codingABI/id3esp32obd2/(threads)

Thread 1 (2025-07-20):

Elevation calculation wrong?

danjulio, 2025-07-20:
Hello.  This is a nice project.  Thank you for publishing it.

I found it while working on a similar project for an ID.4.  I found the GPS decode especially helpful as the ID.3 spreadsheet that is available online doesn't include it.  However I have a question about the constant value "-501" you subtract from the elevation in meters.  I checked the GPS location in your code as well as a location I got from my house with a couple of online mapping services and it seems that the elevation is more accurate if you subtract 512 ("-512") from the data coming from the car.  Can you tell me how you arrived at the number "-501"?

danjulio, 2025-07-29:
Thank you for replying!

I'm located in Colorado, USA.

I do not have access to another GPS device so I used online topographical maps and entered the same latitude and longitude as I saw in my can bus data.  Subtracting 512 got me an elevation that was close to what the maps reported.  I checked two locations.  It also made more sense to me that they would use a power-of-two number like 512 rather than an odd number like 501 (but, of course, i could be wrong!).

I will try to find a location I can drive to that has a documented elevation and compare the data from the car there.  I understand GPS elevation may be inaccurate by several meters.

codingABI, 2025-07-31:
Colorado, cool :-)

These are some deltas of the last days in my region (Germany/Bavaria):

| OBD2 raw data | Official/real altitude | Delta |
| ------------- | ------------- | ------------- |
| 971 | 467 | 504 |
| 951 | 449 | 502 |
| 1221 | 715 | 506 |
| 1223 | 718 | 505 |
| 979 | 472 | 507 |
| 967 | 460 | 507 |
| 1015 | 513 | 502 |
| 1175 | 673 | 502 |
| 1259 | 757 | 502 |
| 963 | 459 | 504 |

This would be an current average delta of ~504m and I assume that the gps altitude is not more accurate plus/minus 10m.

If you get additional samples from colorado we could complare our deltas.

danjulio, 2025-08-03:
Thanks for the interesting info about GPS.  I don't know that much about it.  Can I ask what resource you use to look up elevations?  And yes, I have an ID.4.

codingABI, 2025-08-03:
In Germany/Bavaria we have several sources to look up elevations.

The easiest way is via the government online map https://atlas.bayern.de. You can right click on any map location and get a popup with the elevation ("Höhe (m)"). I used this method for most of my current samples.

For the other samples I used the other option to download the government elevation data https://geodaten.bayern.de/opengeodata/OpenDataDetail.html?pn=dgm1 as a GeoTiff file. In such a GeoTiff file you can use the gdal tools (more precisely with gdallocationinfo) to read out the elevation for a specific location, e.g.

```
gdallocationinfo.exe 740_5297.tif 12.2055532 47.7830211 -wgs84
Report:
  Location: (108P,838L)
  Band 1:
    Value: 757.720031738281
```

=> Elevation for location 12.2055532 47.7830211 is 758m (Dont be confused about the -wgs84 parameter. This does not mean that the elevation is in wgs84 ellipsoid. Is is only for the used x y coordinate format). GeoTiffs or HGTs with DEM data are also available for Austria, Italiy … and I would guess colorado too.

In general I compare the VW ID.3 GPS data with my Garmin 64st device and from this and other gps devices I know that gps elevation is not very accurate at all.

codingABI, 2025-09-15:
> ...
> * Your altitudes are in the range 1600-1700m and I am in the 450-750m range. I will also try to measure higher altitudes. Maybe there is a correlation.

Small Update:

I got some additional samples with higher altitutes

| OBD2 raw data | Official/real altitude | Delta |
| ------------- | ------------- | ------------- |
| 1291 | 787 |504
| 1497 | 998 | 499
| 1901 | 1400 | 501
| 1915 | 1413 | 502
| 1565 | 1065 | 500

=> The average delta for all my samples is ~503

As a result I
- change the delta from 501 to 503
- added my samples as a comment
- added a link to this conversation

in the source code https://github.com/codingABI/id3esp32obd2/blob/main/id3esp32obd2/requests.ino
