codingABI/id3esp32obd2/id3esp32obd2/dashboards.ino

/* ----------- Dashboards  ----------
 * License: 2-Clause BSD License
 * Copyright (c) 2023-2026 codingABI
 */

// First/starting dashboard
void requestDefaultDashboard(byte boardID) {
  // VIN
  checkBTReceive();
  if (boardID != g_requestDashboard) return; // Bluetooth client changed dashboard
  readAndSendVIN();

  // Driving mode position
  checkBTReceive();
  if (boardID != g_requestDashboard) return; // Bluetooth client changed dashboard
  readAndSendDrivingMode();

  // Car operation mode
  checkBTReceive();
  if (boardID != g_requestDashboard) return; // Bluetooth client changed dashboard
  readAndSendCarMode();

  // ODOMETER
  checkBTReceive();
  if (boardID != g_requestDashboard) return; // Bluetooth client changed dashboard
  readAndSendODOMETER();

  // Outside temperature
  checkBTReceive();
  if (boardID != g_requestDashboard) return; // Bluetooth client changed dashboard
  readAndSendTemperatureOutside();

  // Inside temperature
  checkBTReceive();
  if (boardID != g_requestDashboard) return; // Bluetooth client changed dashboard
  readAndSendTemperatureInside();

  // CO2 content interior
  checkBTReceive();
  if (boardID != g_requestDashboard) return; // Bluetooth client changed dashboard
  readAndSendCO2contentInterior();

  // Voltage for 12V battery from analog pin
  readAndSendBAT12V();

  // Compile time
  readAndSendCompileTime();
}

// Speed dashboard
void requestSpeedDashboard() {
  // Speed
  checkBTReceive();
  readAndSendSpeed();
}

// GPS dashboard
void requestGPSDashboard(byte boardID) {
  checkBTReceive();
  if (boardID != g_requestDashboard) return; // Bluetooth client changed dashboard
  readAndSendGPSTime();

  checkBTReceive();
  if (boardID != g_requestDashboard) return; // Bluetooth client changed dashboard
  readAndSendGPSData();
}

// HV dashboard
void requestHVDashboard(byte boardID) {
  // SOC (BMS)
  checkBTReceive();
  if (boardID != g_requestDashboard) return; // Bluetooth client changed dashboard
  readAndSendSOCBMS();

  // Charging state
  checkBTReceive();
  if (boardID != g_requestDashboard) return; // Bluetooth client changed dashboard
  readAndSendChargingState();

  // CruisingRange
  checkBTReceive();
  if (boardID != g_requestDashboard) return; // Bluetooth client changed dashboard
  readAndSendCruisingRange();

  // Circulation pump HV battery
  checkBTReceive();
  if (boardID != g_requestDashboard) return; // Bluetooth client changed dashboard
  readAndSendHVCirculationPump();

  // HV Battery voltage
  checkBTReceive();
  if (boardID != g_requestDashboard) return; // Bluetooth client changed dashboard
  readAndSendHVBatteryV();

  // HV Battery current
  checkBTReceive();
  if (boardID != g_requestDashboard) return; // Bluetooth client changed dashboard
  readAndSendHVBatteryA();

  // HV Dynamic limit for charging
  checkBTReceive();
  if (boardID != g_requestDashboard) return; // Bluetooth client changed dashboard
  readAndSendHVDynamicChargeLimit();

  // HV Battery main temperature
  checkBTReceive();
  if (boardID != g_requestDashboard) return; // Bluetooth client changed dashboard
  readAndSendHVMainTemperature();

  // HV total charge/discharge
  checkBTReceive();
  if (boardID != g_requestDashboard) return; // Bluetooth client changed dashboard
  readAndSendHVTotalChargeDischarge();

  // HV auxilary consumer power
  checkBTReceive();
  if (boardID != g_requestDashboard) return; // Bluetooth client changed dashboard
  readAndSendHVAuxilaryPower();

  // PTC heater battery
  checkBTReceive();
  if (boardID != g_requestDashboard) return; // Bluetooth client changed dashboard
  readAndSendPTCHeaterCurrent();

   // HV capacity
  checkBTReceive();
  if (boardID != g_requestDashboard) return; // Bluetooth client changed dashboard
  readAndSendHVCapacity();
}

// Custom dashboard
void requestMyDashboard(byte boardID) {
  // SOC (BMS)
  checkBTReceive();
  if (boardID != g_requestDashboard) return; // Bluetooth client changed dashboard
  readAndSendSOCBMS();

  // Car operation mode
  checkBTReceive();
  if (boardID != g_requestDashboard) return; // Bluetooth client changed dashboard
  readAndSendCarMode();

  // HV battery voltage
  checkBTReceive();
  if (boardID != g_requestDashboard) return; // Bluetooth client changed dashboard
  readAndSendHVBatteryV();

  // HV battery current
  checkBTReceive();
  if (boardID != g_requestDashboard) return; // Bluetooth client changed dashboard
  readAndSendHVBatteryA();

  // ODOMETER
  checkBTReceive();
  if (boardID != g_requestDashboard) return; // Bluetooth client changed dashboard
  readAndSendODOMETER();

  // HV total charge/discharge
  checkBTReceive();
  if (boardID != g_requestDashboard) return; // Bluetooth client changed dashboard
  readAndSendHVTotalChargeDischarge();
}
