codingABI/id3esp32obd2/id3esp32obd2/secrets.h

// File for data which should not be published to the public

/* MAC address of your Android device. Only this device is allowed to receive data
 * You can see the connecting MAC address by serial output from ESP32 "Bluetooth client connected with address:..."
 */
const char g_macMobileDevice[6] = {0x01,0x02,0x03,0x04,0x05,0x06};
