codingABI/id3esp32obd2/(commit log)

2023-09-17 Additional values
    Add support for
    - HV PTC heater current
    - Outside temperature
    - Inside temperature
    - Cruising range
    - Charging state
    - CO2 content interior
    - GPS time
    - GPS height
    - GPS latitude
    - GPS longitude
2024-12-11 Updates for arduino-esp32 3.0.5
2026-05-15 Fix spelling and whitespaces
    [UDS.ino, dashboards.ino, id3esp32obd2.ino, requests.ino]
